habib1710001/IoT_based_Hydroponic_System/Documents/Automation Basic Logic.pdf

## DC Horizontal Mini Micro Submersible Motor Pump DC 3-4.5V

AC Pump

Display of al the parameters

Arduino

Air Temperature and Humidity Input (DHT 11)

Water Temperature Input
(DS18B20)

EC input

PH input (PH probe)

Water Level Input

Text

PH Down Tank | PH Up tank | Nutrient Tank B | Nutrient Tank A

Water Tank

Main Tank

I2C LCD Display

App /WebPage

Display of all the parameters

Centrifugal Pump

Centrifugal
Pump

Centrifugal
Pump

Centrifugal
Pump

Centrifugal
Pump

Switch on the AC input light from 6: 30 PM to 9:30 PM

Switch on for 10 minutes and switch off for 5 minutes (repeats forever)

Centrifugal Pump

Run the pump if water level drop below 45 mm

Run if the PH goes below 5.5, and run till the pump delivers 10 ml of solution and check after 10 minutes if PH is below 5.5 or not. Repeat the process

To be discussed

To be discussed

Run if the PH goes above 6.5, and run till the pump delivers 10 ml of solution and check after 10 minutes if PH is above 6.5 or not. Repeat the process
