habib1710001/IoT_based_Hydroponic_System/Readme/download.jpg

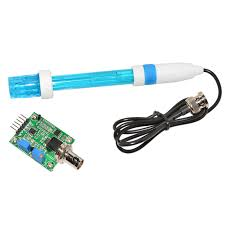
Readme/download.jpg
