habib1710001/IoT_based_Hydroponic_System/Readme/system_picture.jpg

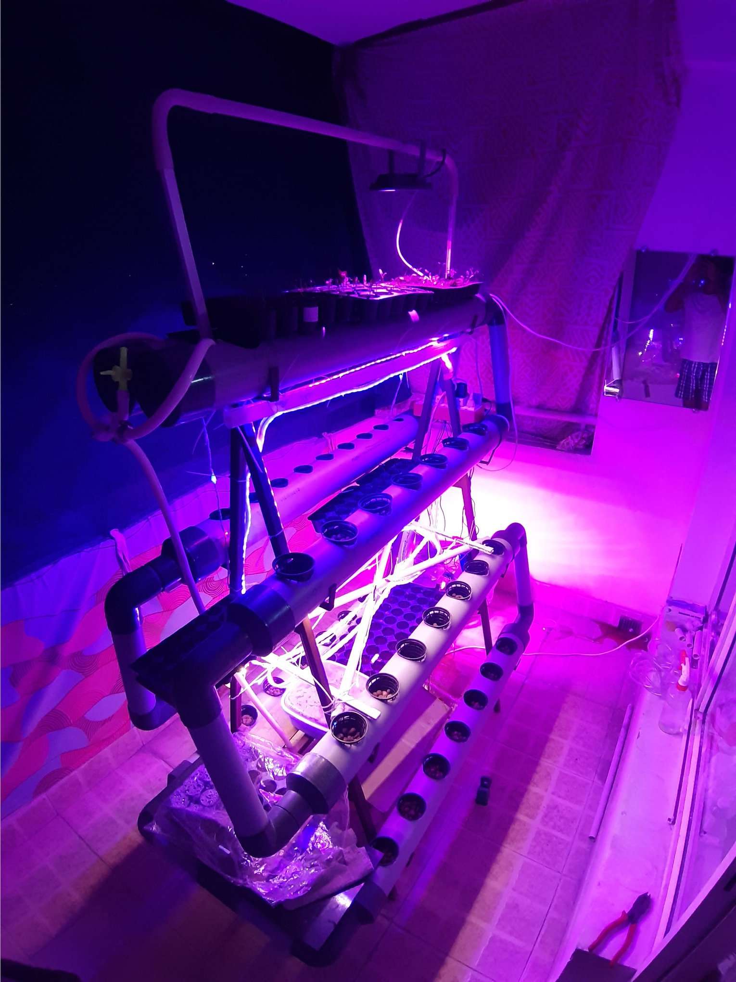
Readme/system_picture.jpg
