habib1710001/IoT_based_Hydroponic_System/Result/thinkspeak.png

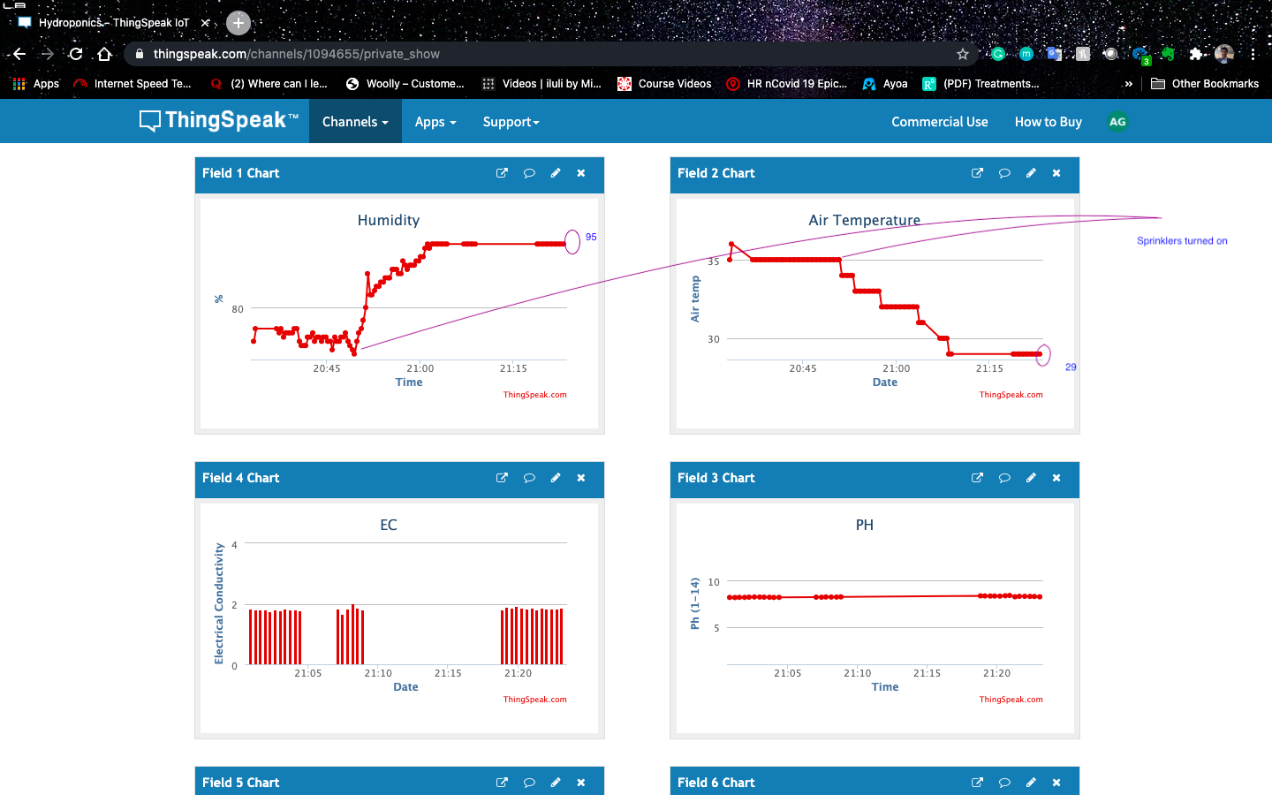
Result/thinkspeak.png
