habib1710001/IoT_based_Hydroponic_System/Circuit_Layout/Hydroponics_v1_bb.pdf

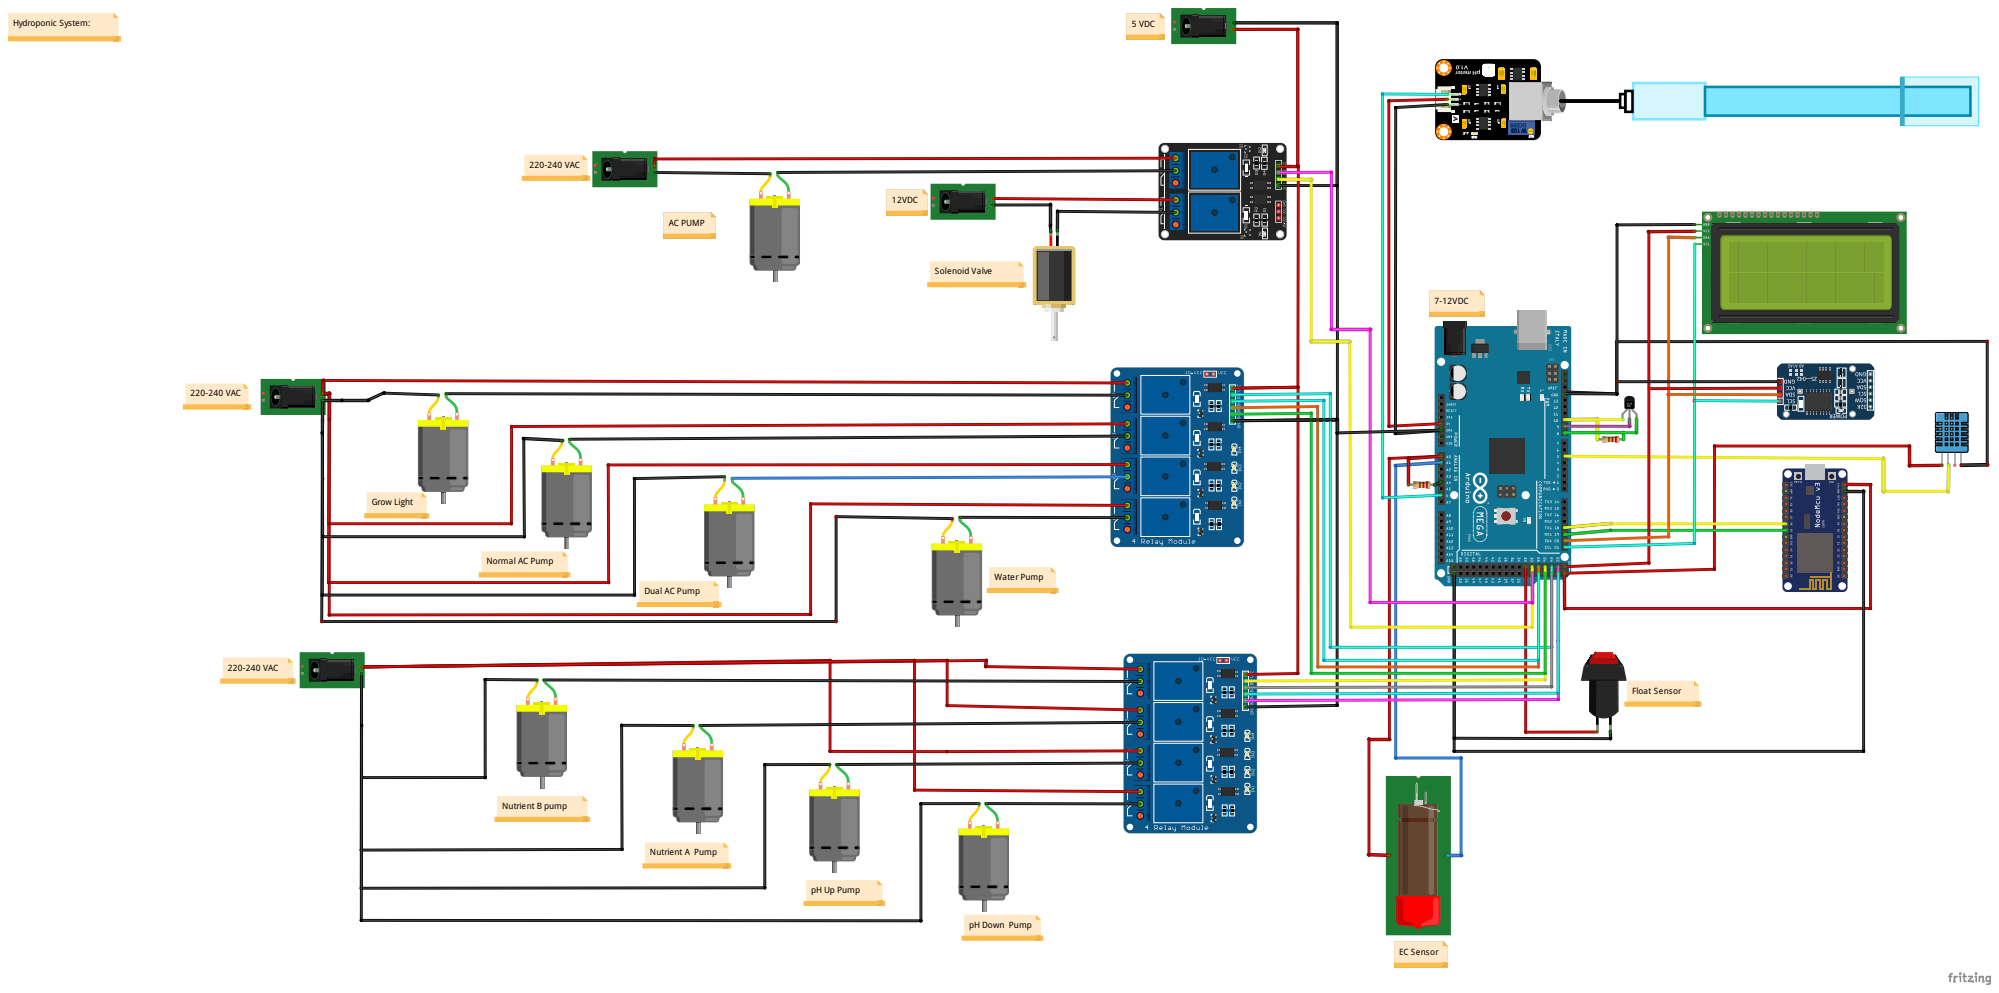
[picture p26: page 1]
5 VDC; Float Sensor; 7-12VDC; Hydroponic System:; AC PUMP; Solenoid Valve; 12VDC; 220-240 VAC; Grow Light; Water Pump; Nutrient A Pump; Nutrient B pump; EC Sensor

Normal AC Pump

Dual AC Pump

pH Up Pump

pH Down Pump
