habib1710001/IoT_based_Hydroponic_System/(list of files, drawings)

Other design files:
Circuit_Layout/Hydroponics_v1.fzz
Circuit_Layout/Parts/2-Channel_relay-5v10a-Fritzing-Part/arduinomega.fzz
Circuit_Layout/Parts/2-Channel_relay-5v10a-Fritzing-Part/bomba.fzz
Circuit_Layout/Parts/2-Channel_relay-5v10a-Fritzing-Part/ec_ph_esp32.fzz
Circuit_Layout/Parts/2-Channel_relay-5v10a-Fritzing-Part/Peristaltic-Pump-Fritzing.fzz
Circuit_Layout/Parts/arduinomega.fzz
Circuit_Layout/Parts/bomba.fzz
Circuit_Layout/Parts/ec_ph_esp32.fzz
Circuit_Layout/Parts/Peristaltic-Pump-Fritzing.fzz
